yashton/theremin/theremin.kicad_pcb

## KiCad design theremin.kicad_pcb (2024-01-26)

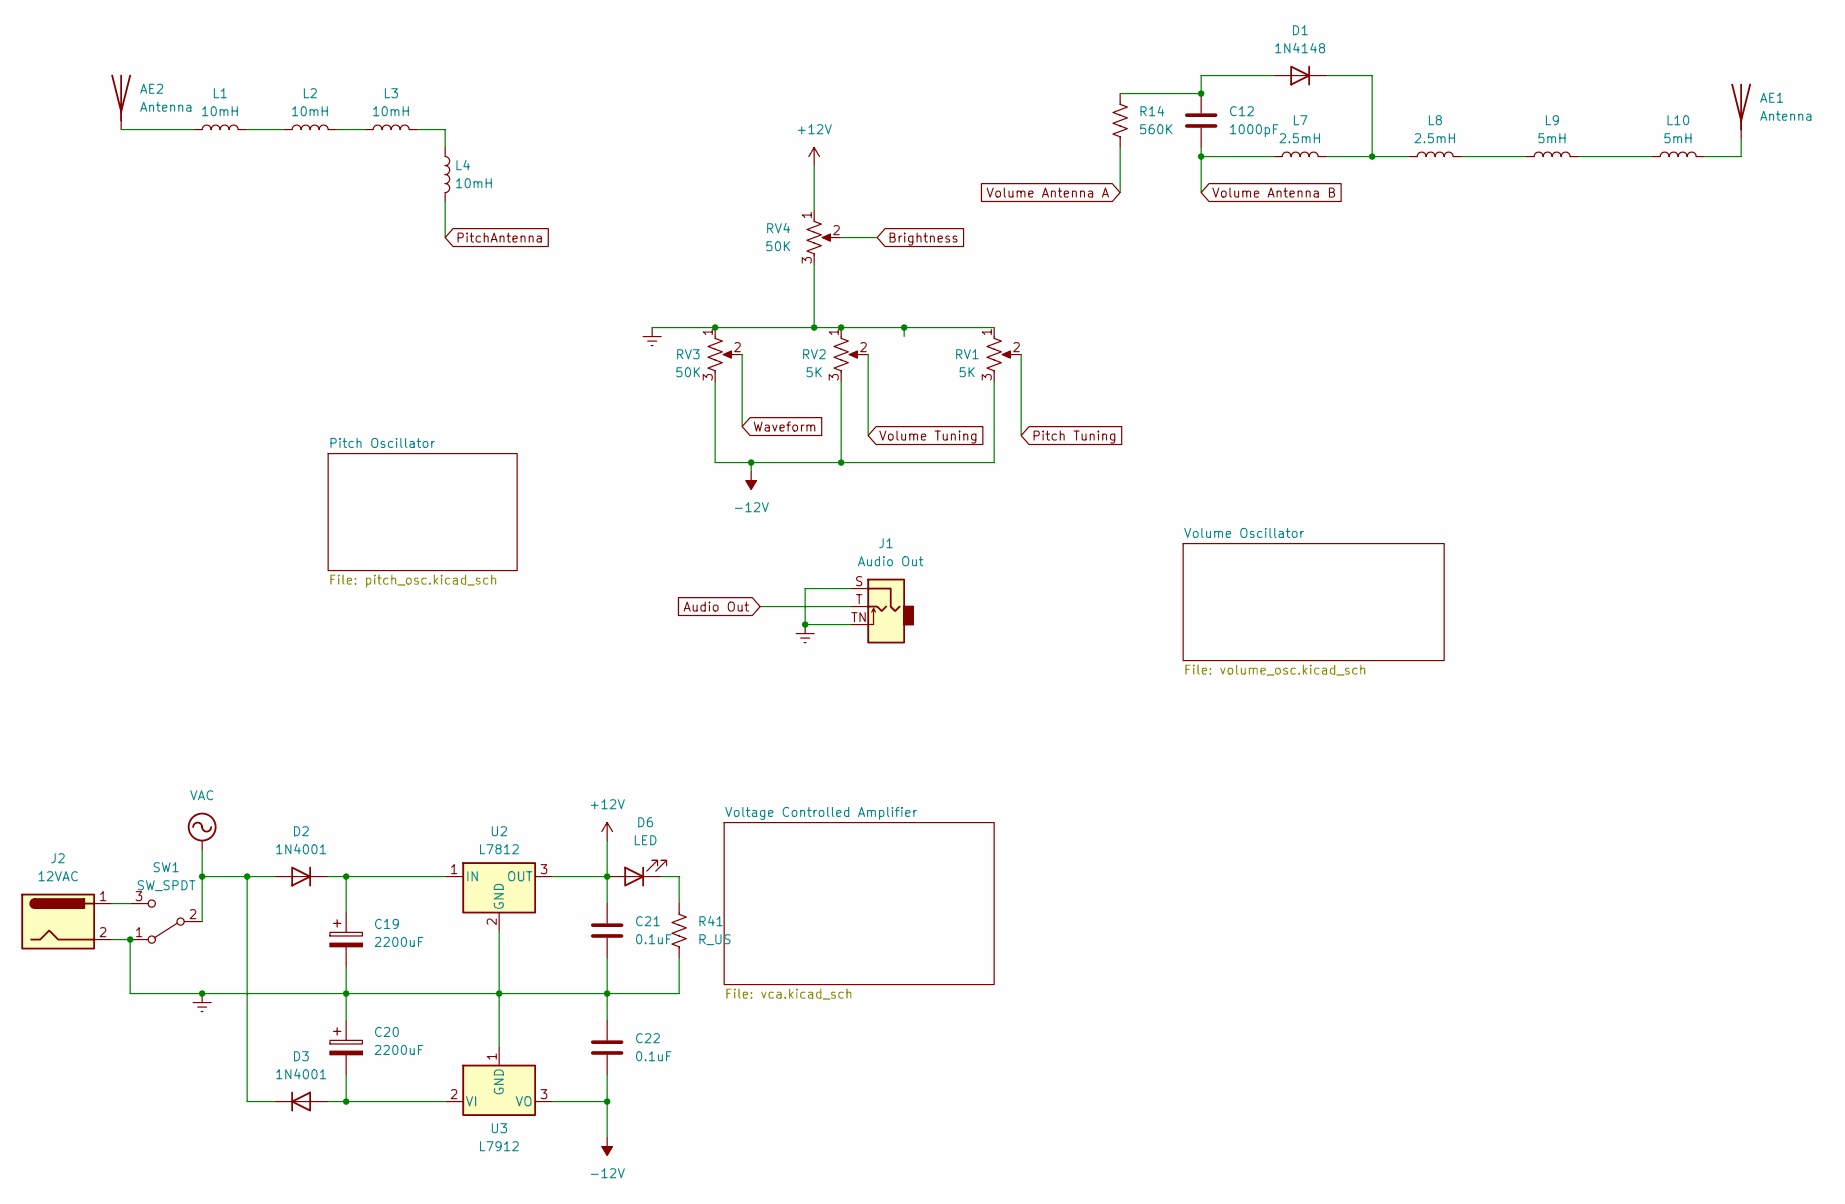
[picture p9: schematic theremin.kicad_sch]

Parts:
AE1, AE2: Antenna; Pin_D1.3mm_L11.0mm
C12: 1000pF; C_0805_2012Metric
C19, C20: 2200uF; CP_Radial_D10.0mm_P3.50mm
C21, C22: 0.1uF; C_1812_4532Metric
D1: 1N4148; D_2010_5025Metric
D2, D3: 1N4001; D_2010_5025Metric
D6: LED; LED_D3.0mm_Horizontal_O1.27mm_Z2.0mm_IRGrey
J1: Audio Out; Jack_3.5mm_CUI_SJ1-3533NG_Horizontal
J2: 12VAC; BarrelJack_CUI_PJ-063AH_Horizontal
L1, L2, L3, L4: 10mH; L_1210_3225Metric
L7, L8: 2.5mH; L_1210_3225Metric
L9, L10: 5mH; L_1210_3225Metric
R14: 560K; R_0805_2012Metric
R41: R_US; R_0805_2012Metric
RV1, RV2: 5K; Potentiometer_Vishay_148-149_Single_Horizontal
RV3, RV4: 50K; Potentiometer_Vishay_148-149_Single_Horizontal
SW1: SW_SPDT; SW_Push_1P2T_Vertical_E-Switch_800UDP8P1A1M6
U2: L7812; TO-220-3_Vertical
U3: L7912; TO-220-3_Vertical

Connections:
+12V: C21.1, D6.2 (A), RV4.1, U2.3 (OUT); also elsewhere on the board
-12V: C22.2, RV1.3, RV2.3, RV3.3, U3.3 (VO); also elsewhere on the board
Audio Out: J1.T; also elsewhere on the board
Brightness: RV4.2; also elsewhere on the board
Earth: C19.2, C20.1, C21.2, C22.1, J1.S, J1.TN, J2.2, R41.1, RV1.1, RV2.1, RV3.1, RV4.3, SW1.1 (A), U2.2 (GND), U3.1 (GND); also elsewhere on the board
unnamed: AE1.1 (A), L10.2
unnamed: AE2.1 (A), L1.1
unnamed: C12.1, D1.2 (A), R14.1
unnamed: D1.1 (K), L7.2, L8.1
unnamed: C19.1, D2.1 (K), U2.1 (IN)
unnamed: C20.2, D3.2 (A), U3.2 (VI)
unnamed: D6.1 (K), R41.2
unnamed: L1.2, L2.1
unnamed: L2.2, L3.1
unnamed: L3.2, L4.1
unnamed: L8.2, L9.1
unnamed: L9.2, L10.1
unnamed: J2.1, SW1.3 (C)
Pitch Tuning: RV1.2; also elsewhere on the board
PitchAntenna: L4.2; also elsewhere on the board
VAC: D2.2 (A), D3.1 (K), SW1.2 (B)
Volume Antenna A: R14.2; also elsewhere on the board
Volume Antenna B: C12.2, L7.1; also elsewhere on the board
Volume Tuning: RV2.2; also elsewhere on the board
Waveform: RV3.2; also elsewhere on the board

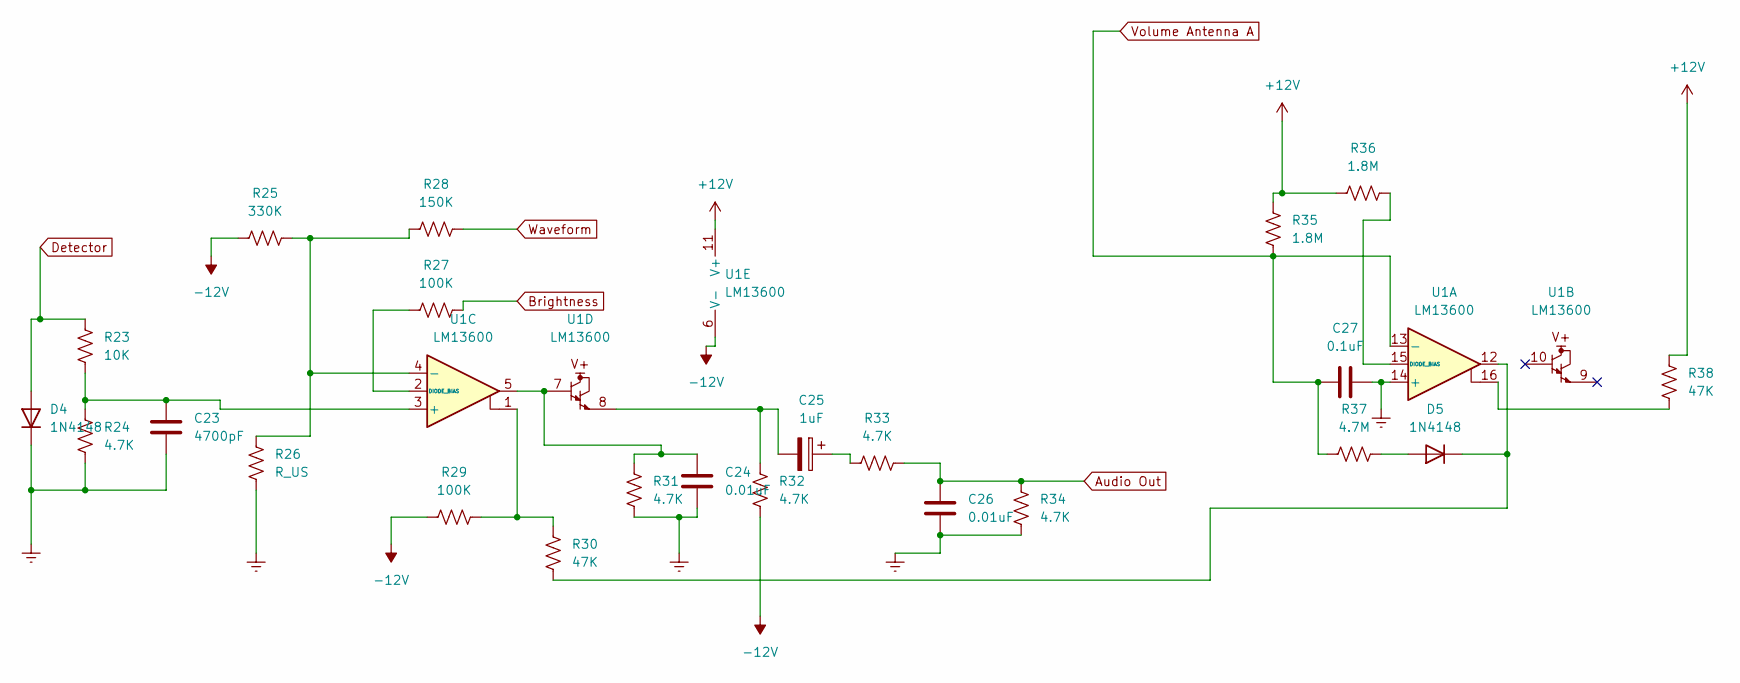
[picture p10: schematic vca.kicad_sch]

Parts:
C23: 4700pF; C_1812_4532Metric
C24, C26: 0.01uF; C_0805_2012Metric
C25: 1uF; CP_Radial_D5.0mm_P2.50mm
C27: 0.1uF; C_1812_4532Metric
D4, D5: 1N4148; D_2010_5025Metric
R23: 10K; R_0805_2012Metric
R24, R31, R32, R33, R34: 4.7K; R_0805_2012Metric
R25: 330K; R_0805_2012Metric
R26: R_US; R_0805_2012Metric
R27, R29: 100K; R_0805_2012Metric
R28: 150K; R_0805_2012Metric
R30, R38: 47K; R_0805_2012Metric
R35, R36: 1.8M; R_0805_2012Metric
R37: 4.7M; R_0805_2012Metric
U1: LM13600; DIP-16_W7.62mm_LongPads

Connections:
+12V: R35.2, R36.2, R38.1, U1.11 (V+); also elsewhere on the board
-12V: R25.1, R29.2, R32.2, U1.6 (V-); also elsewhere on the board
Audio Out: C26.1, R33.2, R34.2; also elsewhere on the board
Brightness: R27.1; also elsewhere on the board
Detector: D4.2 (A), R23.1; also elsewhere on the board
Earth: C23.2, C24.2, C26.2, C27.2, D4.1 (K), R24.2, R26.1, R31.2, R34.1, U1.14 (+); also elsewhere on the board
unnamed: C24.1, R31.1, U1.5, U1.7
unnamed: C25.1, R33.1
unnamed: C25.2, R32.1, U1.8
unnamed: D5.2 (A), R37.1
unnamed: D5.1 (K), R30.2, U1.12
unnamed: R29.1, R30.1, U1.1
unnamed: R38.2, U1.16
unnamed: R36.1, U1.15 (DIODE_BIAS)
unnamed: C23.1, R23.2, R24.1, U1.3 (+)
unnamed: R25.2, R26.2, R28.2, U1.4 (-)
unnamed: R27.2, U1.2 (DIODE_BIAS)
Volume Antenna A: C27.1, R35.1, R37.2, U1.13 (-); also elsewhere on the board
Waveform: R28.1; also elsewhere on the board

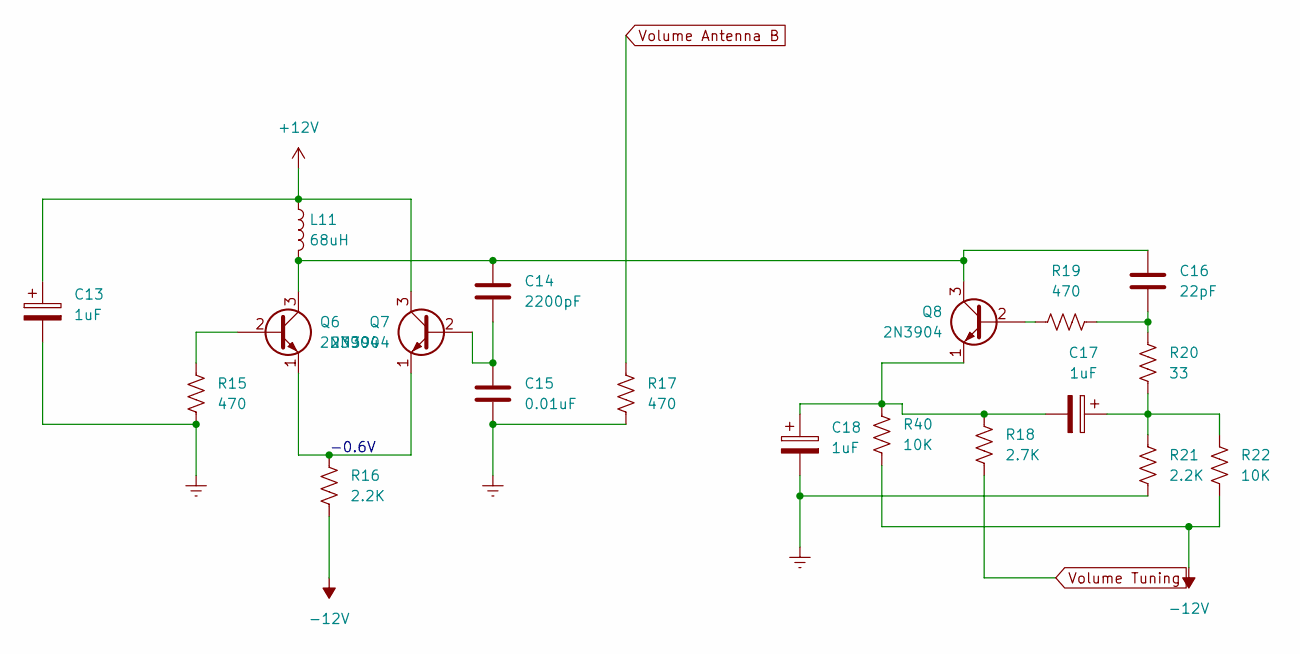
[picture p11: schematic volume_osc.kicad_sch]

Parts:
C13, C17, C18: 1uF; CP_Radial_D5.0mm_P2.50mm
C14: 2200pF; C_0805_2012Metric
C15: 0.01uF; C_0805_2012Metric
C16: 22pF; C_0805_2012Metric
L11: 68uH; L_1210_3225Metric
Q6, Q7, Q8: 2N3904; TO-92_Inline
R15, R17, R19: 470; R_0805_2012Metric
R16, R21: 2.2K; R_0805_2012Metric
R18: 2.7K; R_0805_2012Metric
R20: 33; R_0805_2012Metric
R22, R40: 10K; R_0805_2012Metric

Connections:
+12V: C13.1, L11.1, Q7.3 (C); also elsewhere on the board
-12V: R16.2, R22.1, R40.2; also elsewhere on the board
Earth: C13.2, C15.2, C18.2, R15.2, R17.2, R21.1; also elsewhere on the board
unnamed: C16.2, R19.2, R20.2
unnamed: C17.1, R20.1, R21.2, R22.2
unnamed: Q6.2 (B), R15.1
unnamed: C14.1, C16.1, L11.2, Q6.3 (C), Q8.3 (C)
unnamed: Q6.1 (E), Q7.1 (E), R16.1
unnamed: C14.2, C15.1, Q7.2 (B)
unnamed: Q8.2 (B), R19.1
unnamed: C17.2, C18.1, Q8.1 (E), R18.1, R40.1
Volume Antenna B: R17.1; also elsewhere on the board
Volume Tuning: R18.2; also elsewhere on the board

Notes on the sheet:
-0.6V

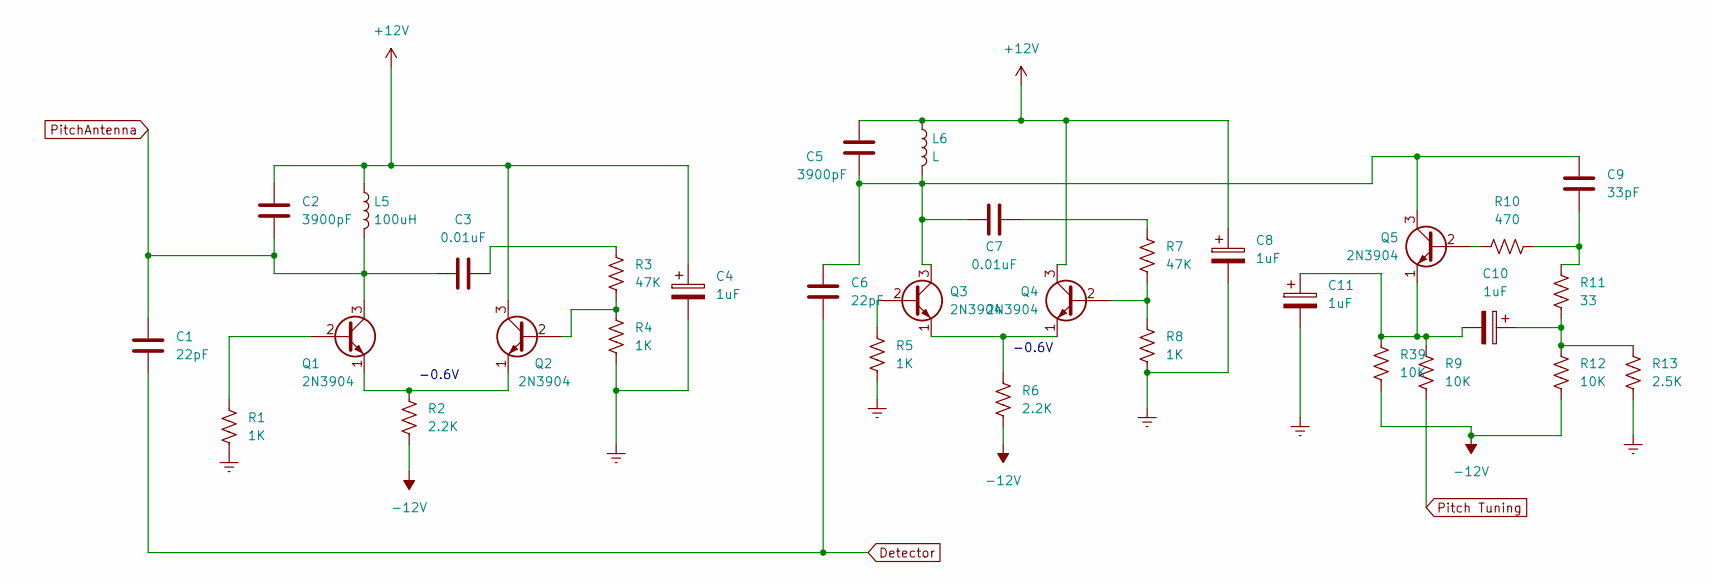
[picture p12: schematic pitch_osc.kicad_sch]

Parts:
C1, C6: 22pF; C_0805_2012Metric
C2, C5: 3900pF; C_0805_2012Metric
C3, C7: 0.01uF; C_0805_2012Metric
C4, C8, C10, C11: 1uF; CP_Radial_D5.0mm_P2.50mm
C9: 33pF; C_0805_2012Metric
L5: 100uH; L_1210_3225Metric
L6: L; L_1210_3225Metric
Q1, Q2, Q3, Q4, Q5: 2N3904; TO-92_Inline
R1, R4, R5, R8: 1K; R_0805_2012Metric
R2, R6: 2.2K; R_0805_2012Metric
R3, R7: 47K; R_0805_2012Metric
R9, R12, R39: 10K; R_0805_2012Metric
R10: 470; R_0805_2012Metric
R11: 33; R_0805_2012Metric
R13: 2.5K; R_0805_2012Metric

Connections:
+12V: C2.1, C4.1, C5.1, C8.1, L5.1, L6.1, Q2.3 (C), Q4.3 (C); also elsewhere on the board
-12V: R2.2, R6.2, R12.1, R39.2; also elsewhere on the board
Detector: C1.2, C6.2; also elsewhere on the board
Earth: C4.2, C8.2, C11.2, R1.2, R4.2, R5.2, R8.2, R13.1; also elsewhere on the board
unnamed: C3.2, R3.1
unnamed: C7.2, R7.1
unnamed: C9.1, R10.2, R11.2
unnamed: C10.1, R11.1, R12.2, R13.2
unnamed: Q1.2 (B), R1.1
unnamed: Q1.1 (E), Q2.1 (E), R2.1
unnamed: Q2.2 (B), R3.2, R4.1
unnamed: Q3.2 (B), R5.1
unnamed: C5.2, C6.1, C7.1, C9.2, L6.2, Q3.3 (C), Q5.3 (C)
unnamed: Q3.1 (E), Q4.1 (E), R6.1
unnamed: Q4.2 (B), R7.2, R8.1
unnamed: Q5.2 (B), R10.1
unnamed: C10.2, C11.1, Q5.1 (E), R9.1, R39.1
Pitch Tuning: R9.2; also elsewhere on the board
PitchAntenna: C1.1, C2.2, C3.1, L5.2, Q1.3 (C); also elsewhere on the board

Notes on the sheet:
-0.6V

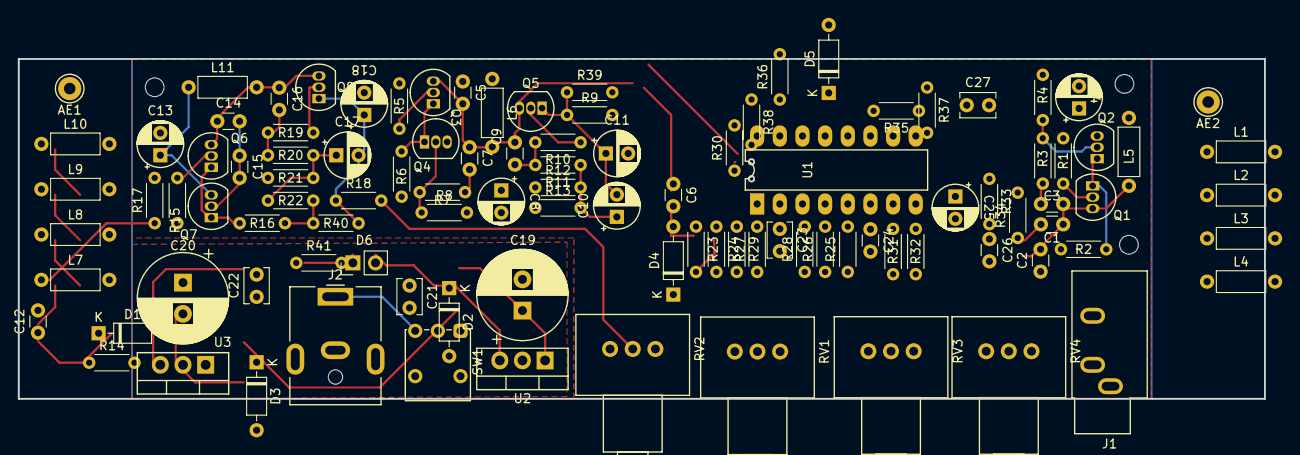
[picture p13: board theremin.kicad_pcb from above]

Board: 2 copper layers, 139.7 x 38.1 mm, 105 parts (0 on the bottom side), 58 nets.
