yashton/theremin/(commit log)

2024-01-24 Initial schematic copied from Moog article.
    [pitch_osc.kicad_sch, theremin.kicad_pcb, theremin.kicad_sch, variable_pitch_osc.kicad_sch, vca.kicad_sch, volume_osc.kicad_sch]
2024-01-24 Initial placement for pcb.
    [theremin.kicad_pcb]
2024-01-25 Placed in smd and through.
    [pitch_osc.kicad_sch, theremin.kicad_pcb, theremin.kicad_sch, theremin_moog.kicad_pcb, vca.kicad_sch, volume_osc.kicad_sch]
2024-01-25 Layout cleanup for smd and through
    [pitch_osc.kicad_sch, theremin.kicad_sch, theremin_tht.kicad_pcb, volume_osc.kicad_sch]
2024-01-25 Small update
    [theremin_tht.kicad_pcb]
2024-01-26 Finished VPO
    [theremin.kicad_pcb, theremin_smd.kicad_pcb]
